hbates00/16.002-Unified-Engineering-Signals-and-Systems/Figures/sketch.png

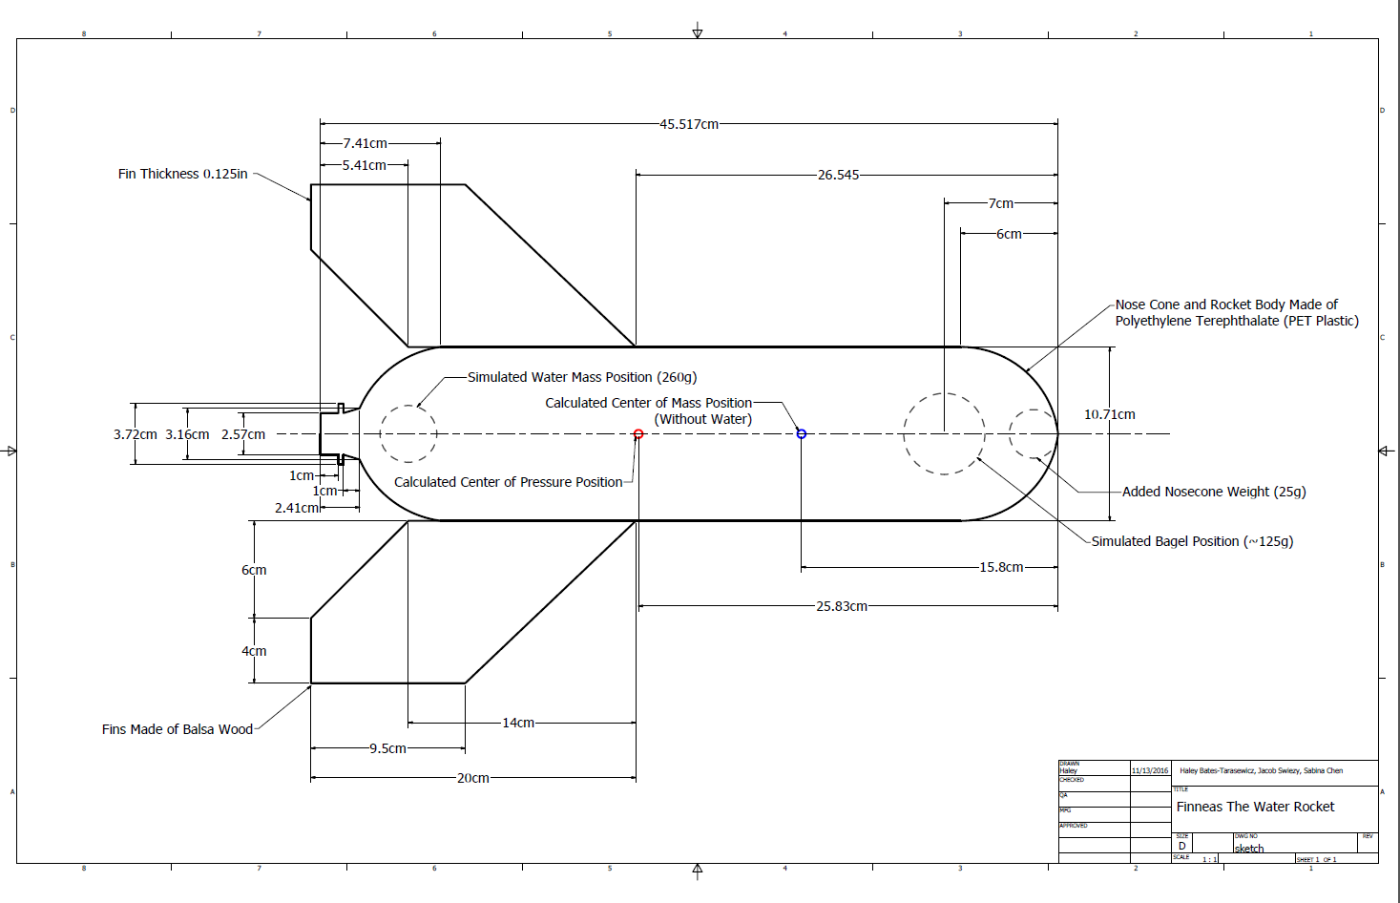
Figures/sketch.png
