hbates00/16.002-Unified-Engineering-Signals-and-Systems/Water_rocket_lab/Figures/alpha vs water.png

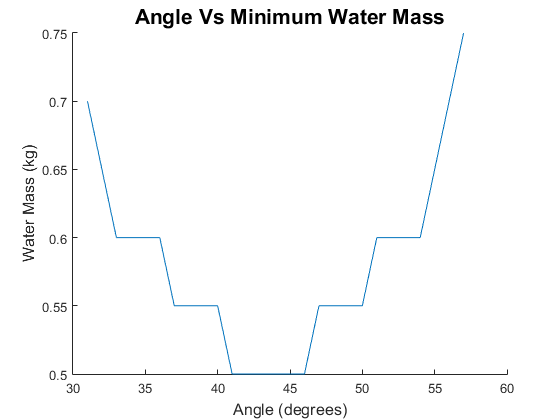
Water_rocket_lab/Figures/alpha vs water.png
