hbates00/16.002-Unified-Engineering-Signals-and-Systems/Water_rocket_lab/Figures/Water Mass Vs Distance.png

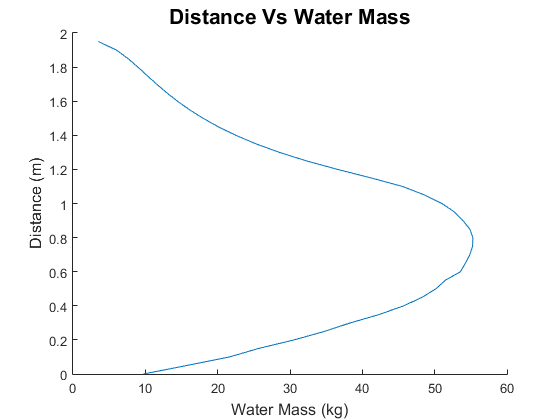
Water_rocket_lab/Figures/Water Mass Vs Distance.png
