hbates00/16.002-Unified-Engineering-Signals-and-Systems/(list of files, cad)

Other CAD files:
Figures/sketch.idw
Figures/sketch.ipt
