hbates00/16.002-Unified-Engineering-Signals-and-Systems/Figures/rocket sketch.pdf

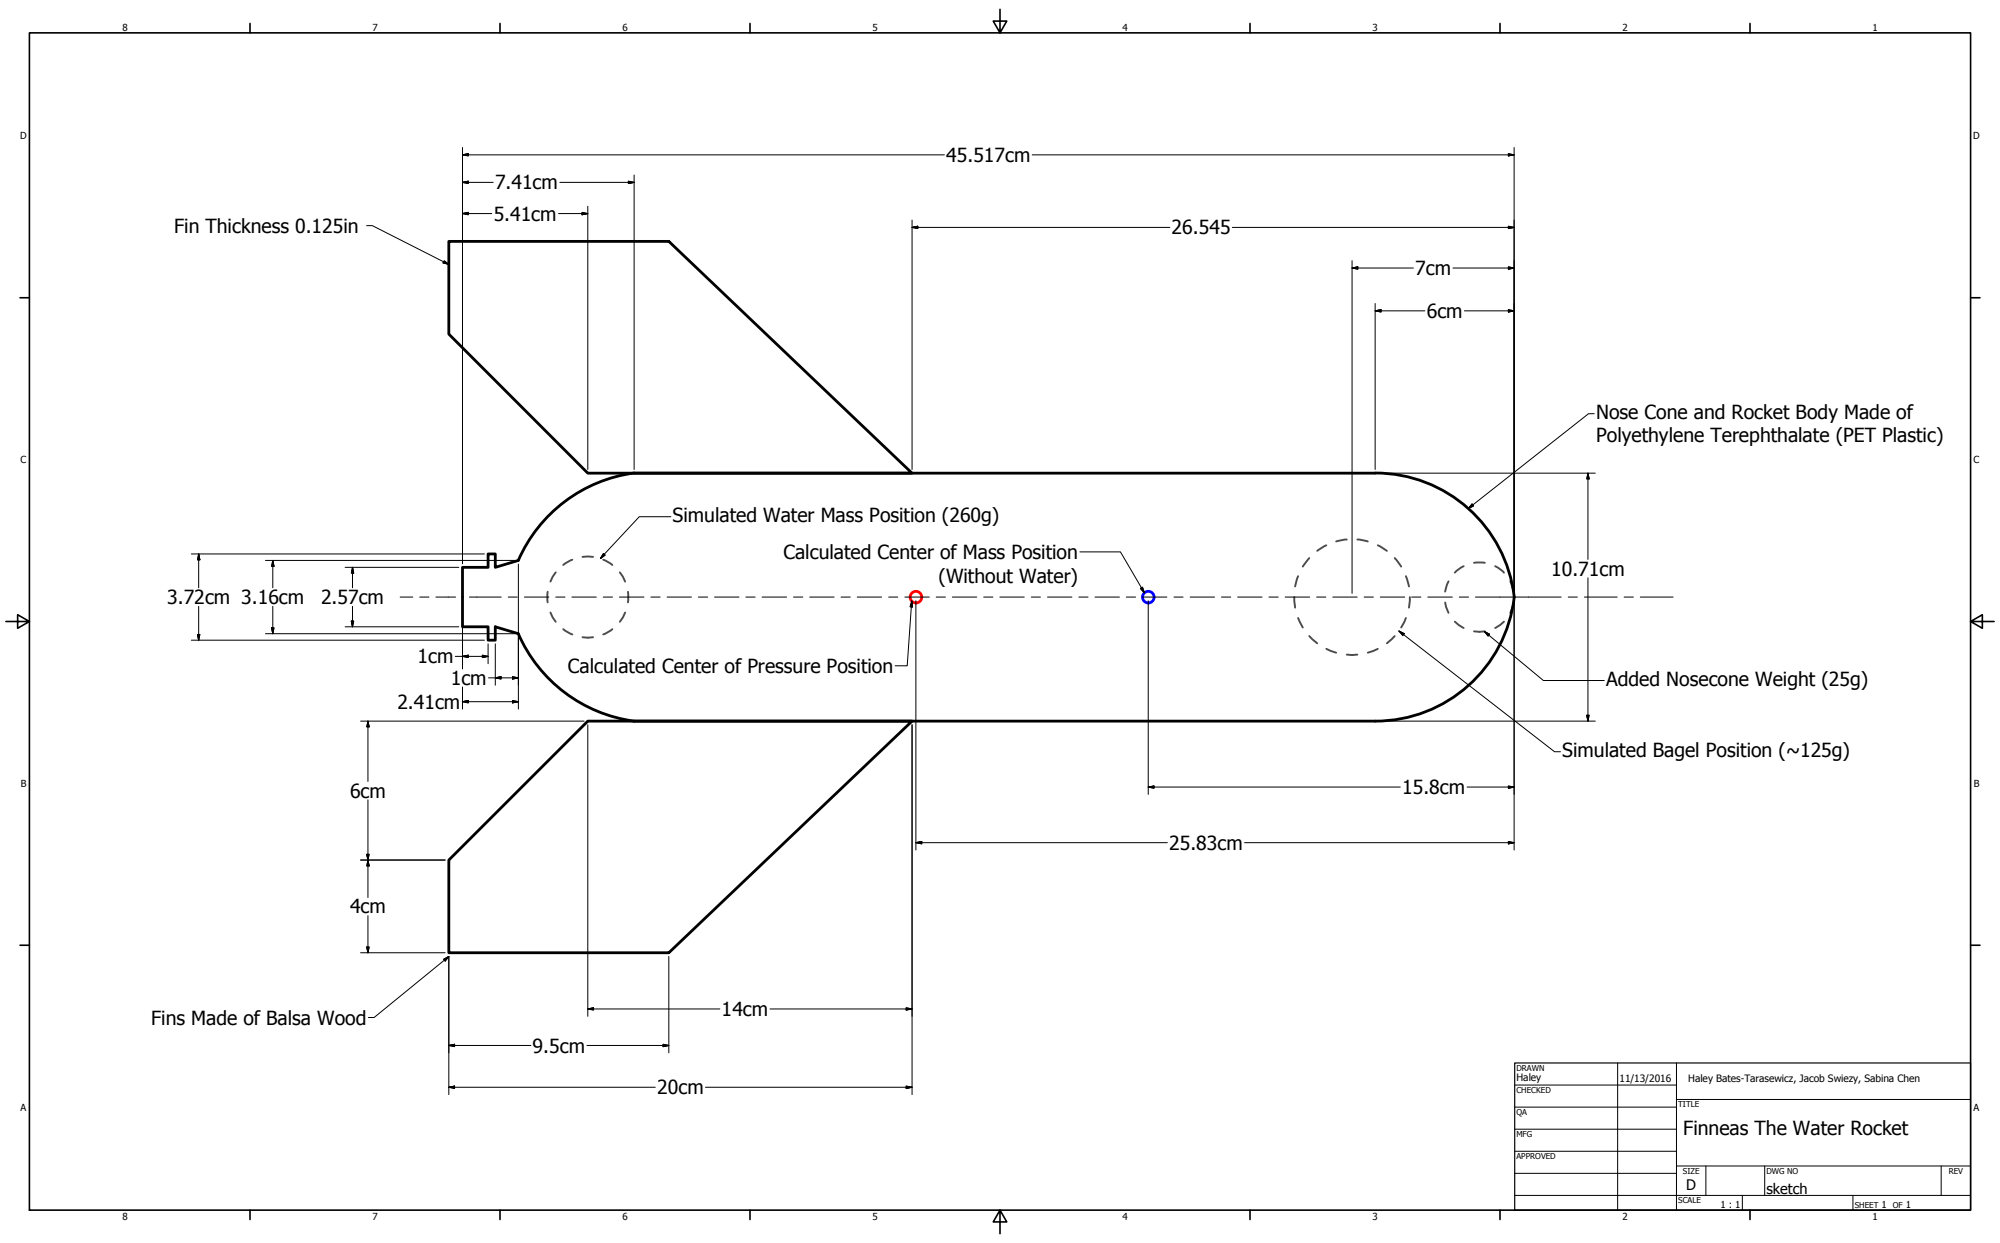
[picture p15: page 1]
SHEET 1 OF 1; DRAWN; CHECKED; MFG; APPROVED; Haley; DWG NO sketch; SIZE D; SCALE; REV; (Without Water); Fin Thickness 0.125in

Nose Cone and Rocket Body Made of
Polyethylene Terephthalate (PET Plastic)

Simulated Water Mass Position (260g)

Calculated Center of Mass Position

Calculated Center of Pressure Position

Added Nosecone Weight (25g)

Simulated Bagel Position (~125g)

Fins Made of Balsa Wood

Haley Bates-Tarasewicz, Jacob Swiezy, Sabina Chen

TITLE
Finneas The Water Rocket
